armtronix/BA020_Wifi_BT_HDR_Board/(notices)

Notices in the files:
Arduino/Wifi_Bt_Esp32_Heavy_Duty_Relay_Board_with_encryption/HLW8012-1.1.1/src/HLW8012.cpp:
This program is free software: you can redistribute it and/or modify
it under the terms of the GNU General Public License as published by
the Free Software Foundation, either version 3 of the License, or
(at your option) any later version.
